Abbas-JawadWala/ESP32_BoardV1.1/1.1.22.pdf

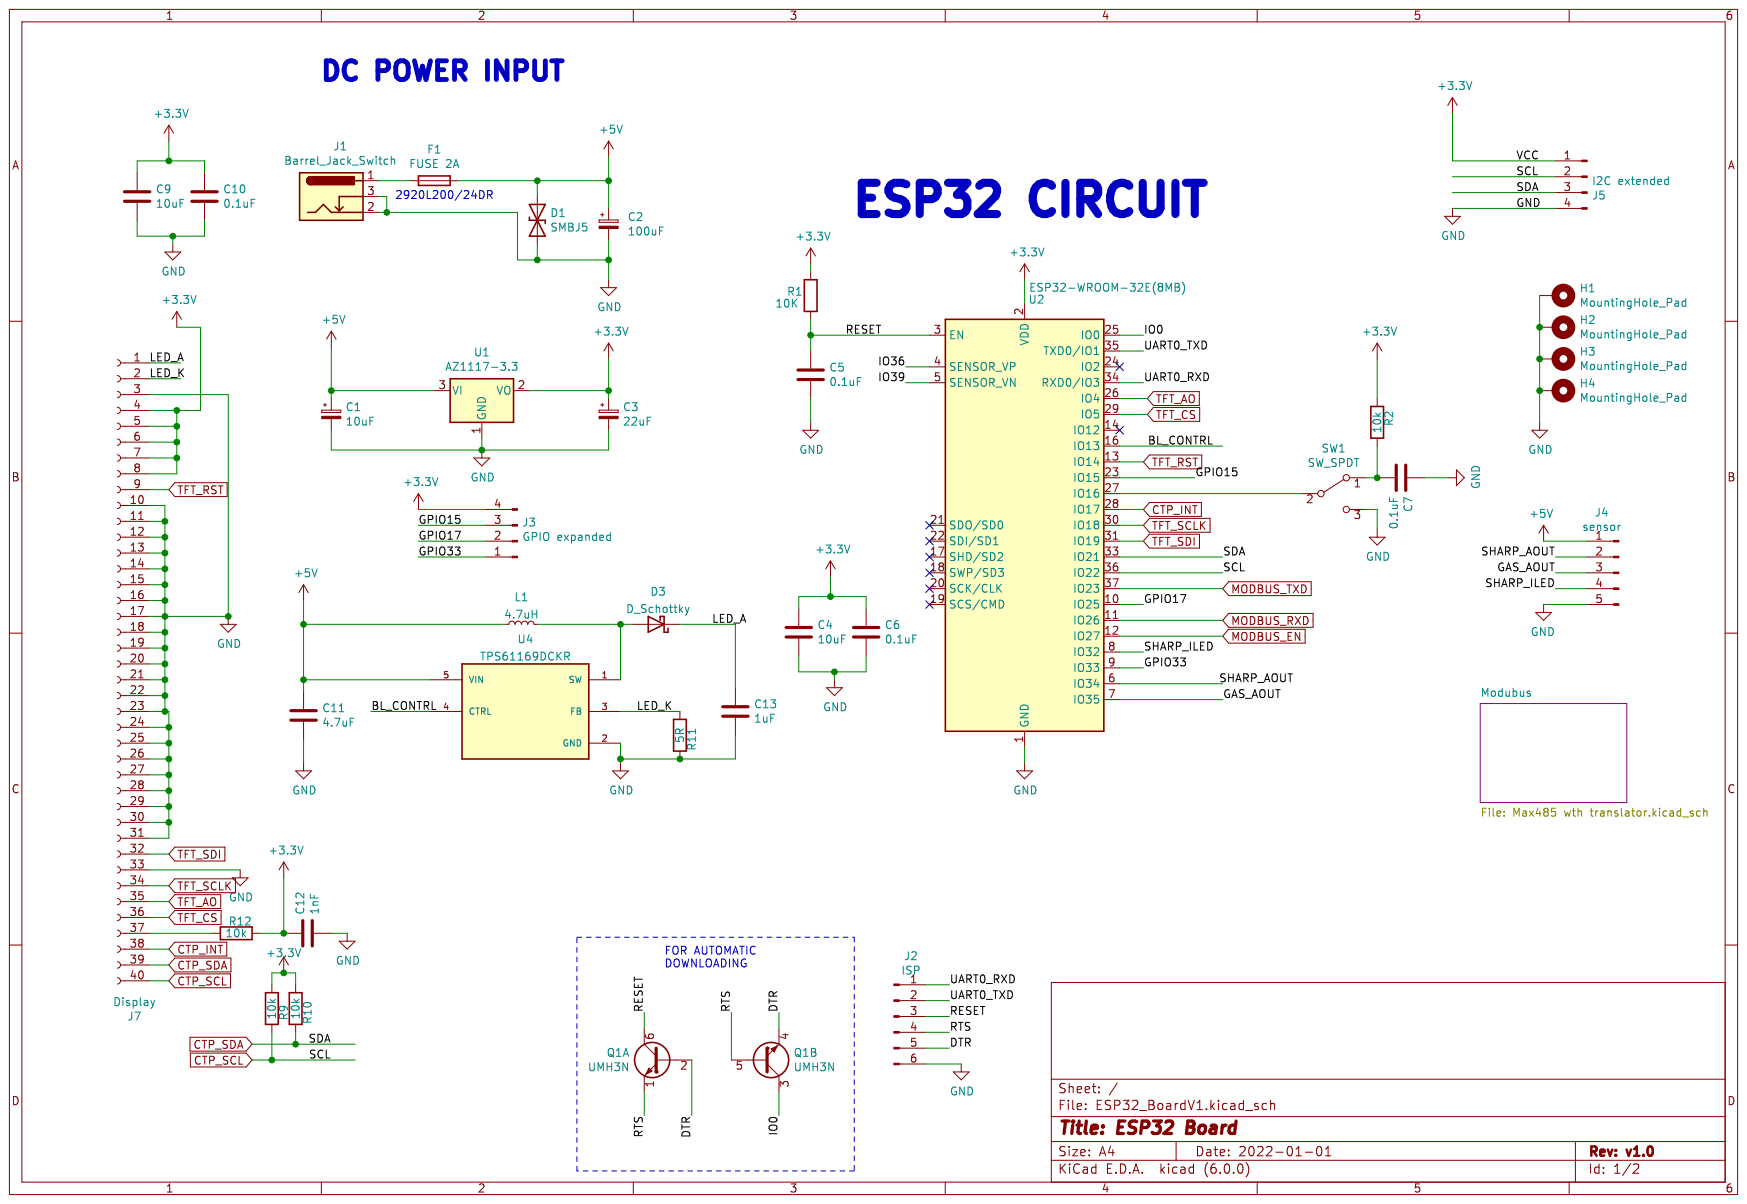
[picture p1: page 1]

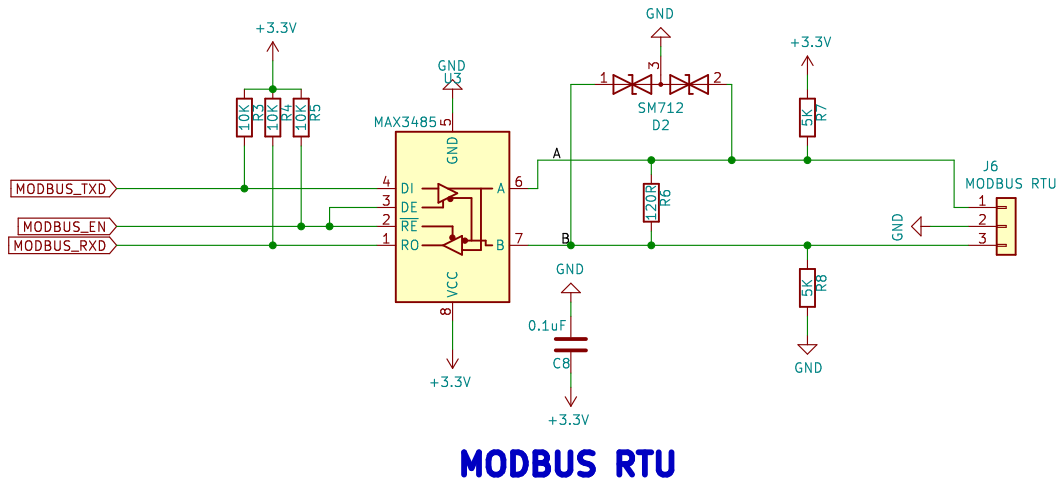
[picture p2: page 2]
