Abbas-JawadWala/ESP32_BoardV1.1/ESP32_BoardV1.kicad_pcb

## KiCad design ESP32_BoardV1.kicad_pcb (2022-02-02)

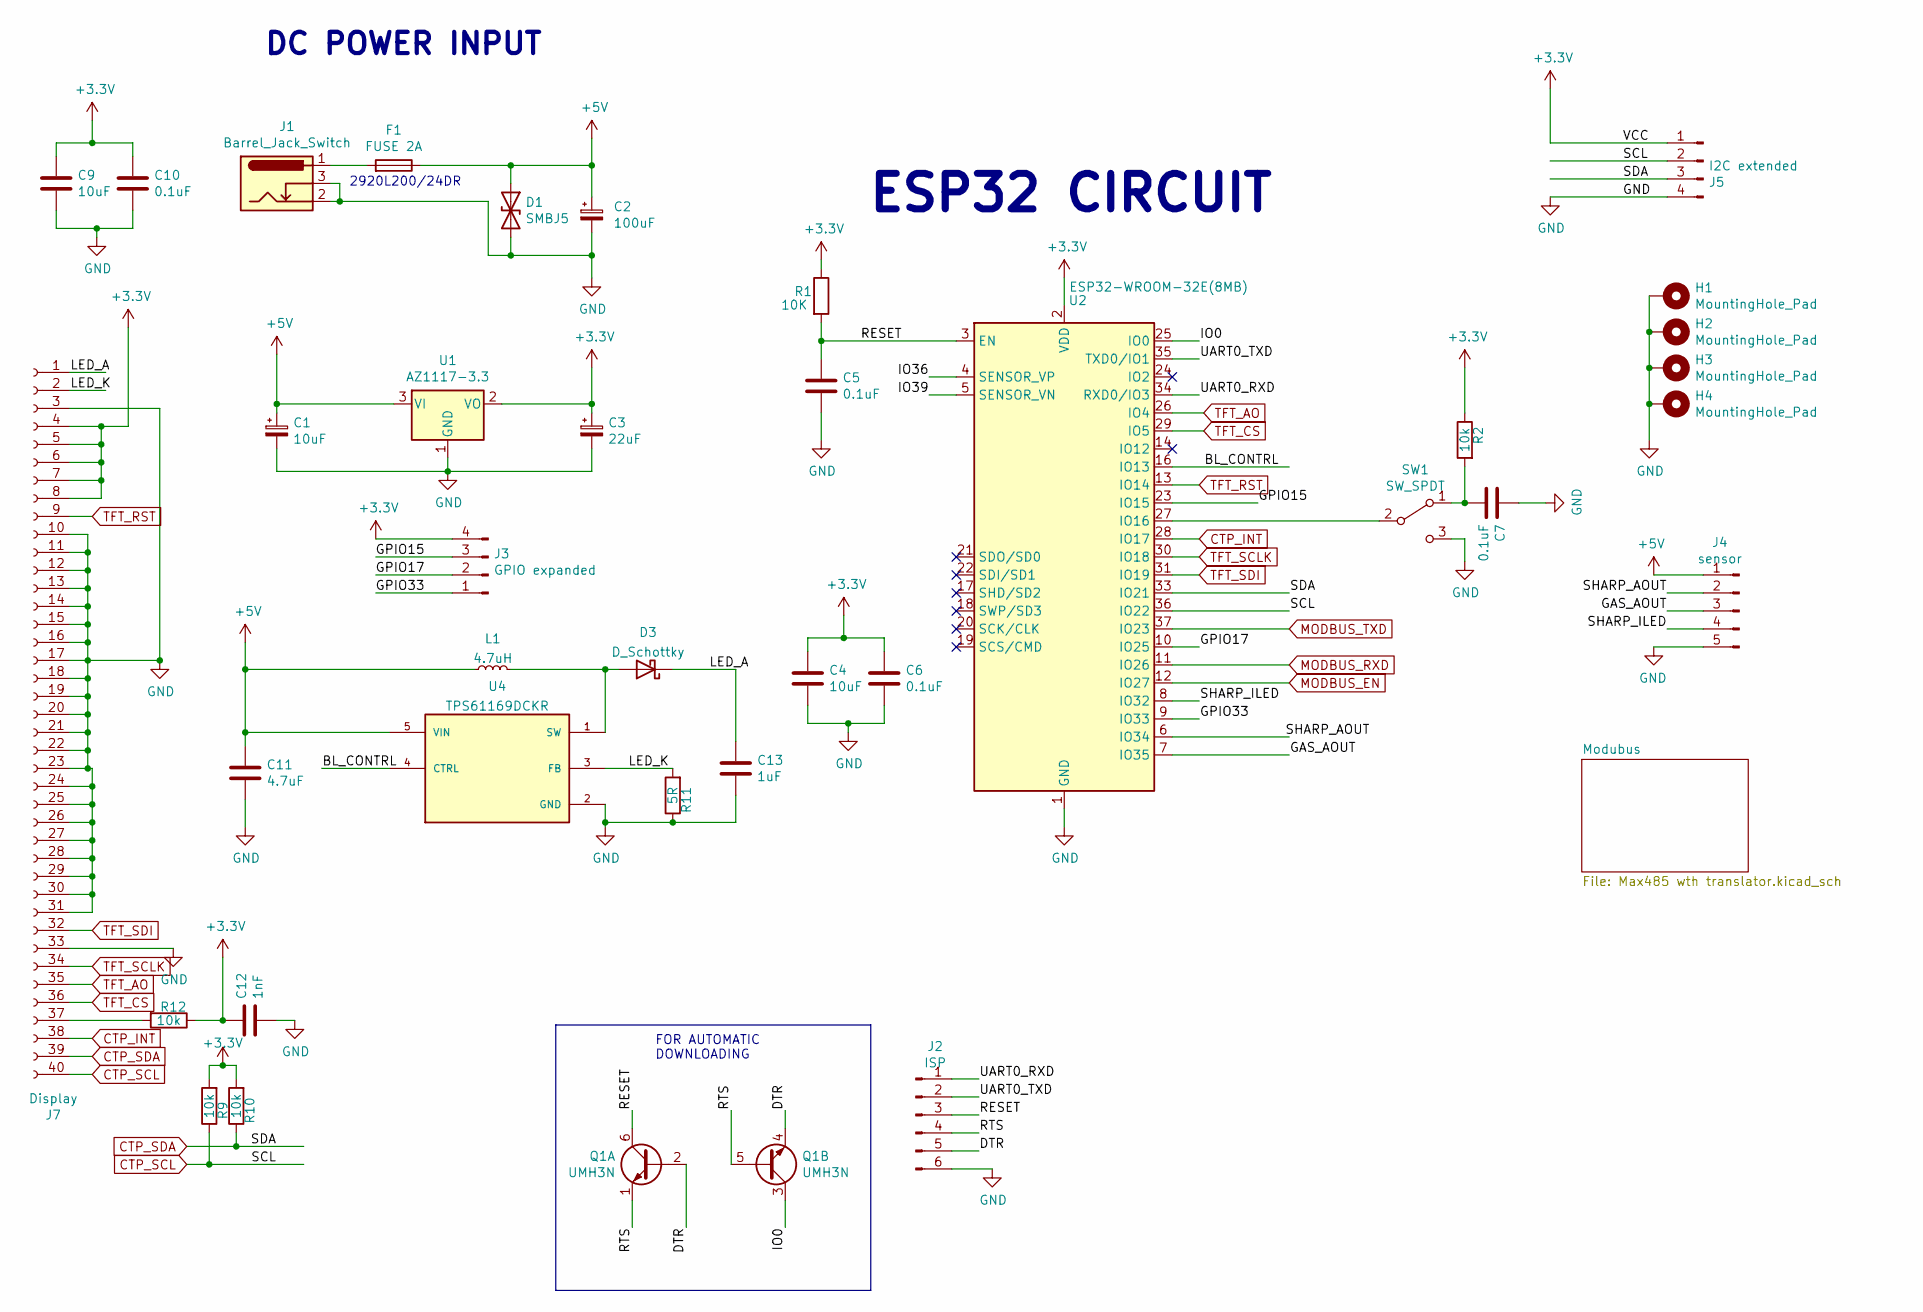
[picture p3: schematic ESP32_BoardV1.kicad_sch, ESP32 Board]

Parts:
C1: 10uF; CP_Elec_3x5.4
C2: 100uF; CP_Elec_6.3x5.4
C3: 22uF; CP_Elec_5x5.4
C4, C9: 10uF; C_0402_1005Metric_Pad0.74x0.62mm_HandSolder
C5, C6, C7, C10: 0.1uF; C_0402_1005Metric_Pad0.74x0.62mm_HandSolder
C11: 4.7uF; C_0402_1005Metric; MPN C1005X5R1A475K050BC
C12: 1nF; C_0402_1005Metric; MPN 0402ZC102KAT2A
C13: 1uF; C_0402_1005Metric; MPN C1005X6S1A105K050BC
D1: SMBJ5; D_SMB
D3: D_Schottky; D_SOD-123F; MPN RB160MM-90TR
F1: FUSE 2A; Fuse_1206_3216Metric
H1, H2, H3, H4: MountingHole_Pad; MountingHole_4.3mm_M4_Pad_Via
J1: Barrel_Jack_Switch; BarrelJack_CLIFF_FC681465S_SMT_Horizontal
J2: ISP; PinHeader_1x06_P2.54mm_Vertical
J3: GPIO expanded; JST_SM04B-SRSS-TB(LF)(SN); MPN JST_SM04B-SRSS-TB(LF)(SN)
J4: sensor; JST_SM05B-SRSS-TB(LF)(SN); MPN JST_SM05B-SRSS-TB(LF)(SN)
J5: I2C extended; JST_SM04B-SRSS-TB(LF)(SN); MPN JST_SM04B-SRSS-TB(LF)(SN)
J7: Display; Hirose_FH12-40S-0.5SH_1x40-1MP_P0.50mm_Horizontal
L1: 4.7uH; L_1008_2520Metric; MPN NRS4018T100MDGJ
Q1: UMH3N; SOT-363_SC-70-6
R1: 10K; R_0402_1005Metric_Pad0.72x0.64mm_HandSolder
R2, R9, R10, R12: 10k; R_0402_1005Metric_Pad0.72x0.64mm_HandSolder
R11: 5R; R_0402_1005Metric_Pad0.72x0.64mm_HandSolder
SW1: SW_SPDT; SW_Slide_1P2T_CK_OS102011MS2Q
U1: AZ1117-3.3; SOT-223-3_TabPin2; MPN AZ1117-3.3
U2: ESP32-WROOM-32E(8MB); ESP32-WROOM-32; MPN ESP32-WROOM-32
U4: TPS61169DCKR; SOT-353_SC-70-5; PARTREV A

Connections:
+3V3: C3.1, C4.1, C6.1, C9.1, C10.1, C12.1, J3.4, J5.1, J7.4, J7.5, J7.6, J7.7, J7.8, R1.1, R2.1, R9.2, R10.2, R12.1, U1.2 (VO), U2.2 (VDD); also elsewhere on the board
+5V: C1.1, C2.1, C11.1, D1.1 (A1), F1.1, J4.1, L1.1, U1.3 (VI), U4.5 (VIN)
/BL_CONTRL: U2.16 (IO13), U4.4 (CTRL)
/DTR: J2.5, Q1.2 (B1), Q1.4 (E2)
/GAS_AOUT: J4.3, U2.7 (IO35)
/GPIO15: J3.3, U2.23 (IO15)
/GPIO17: J3.2, U2.10 (IO25)
/GPIO33: J3.1, U2.9 (IO33)
/IO0: Q1.3 (C2), U2.25 (IO0)
/IO36: U2.4 (SENSOR_VP)
/IO39: U2.5 (SENSOR_VN)
/LED_A: C13.1, D3.1 (K), J7.1
/LED_K: J7.2, R11.2, U4.3 (FB)
/RESET: C5.1, J2.3, Q1.6 (C1), R1.2, U2.3 (EN)
/RTS: J2.4, Q1.1 (E1), Q1.5 (B2)
/SHARP_AOUT: J4.2, U2.6 (IO34)
/SHARP_ILED: J4.4, U2.8 (IO32)
/UART0_RXD: J2.1, U2.34 (RXD0/IO3)
/UART0_TXD: J2.2, U2.35 (TXD0/IO1)
CTP_INT: J7.38, U2.28 (IO17)
CTP_SCL: J5.2, J7.40, R9.1, U2.36 (IO22)
CTP_SDA: J5.3, J7.39, R10.1, U2.33 (IO21)
GND: C1.2, C2.2, C3.2, C4.2, C5.2, C6.2, C7.1, C9.2, C10.2, C11.2, C12.2, C13.2, D1.2 (A2), H1.1, H2.1, H3.1, H4.1, J1.2, J1.3, J2.6, J4.5, J5.4, J7.3, J7.10, J7.11, J7.12, J7.13, J7.14, J7.15, J7.16, J7.17, J7.18, J7.19, J7.20, J7.21, J7.22, J7.23, J7.24, J7.25, J7.26, J7.27, J7.28, J7.29, J7.30, J7.31, J7.33, R11.1, SW1.3 (C), U1.1 (GND), U2.1 (GND), U2.15 (GND), U2.38 (GND), U2.39 (GND), U4.2 (GND); also elsewhere on the board
MODBUS_EN: U2.12 (IO27); also elsewhere on the board
MODBUS_RXD: U2.11 (IO26); also elsewhere on the board
MODBUS_TXD: U2.37 (IO23); also elsewhere on the board
unnamed: C7.2, R2.2, SW1.1 (A)
unnamed: D3.2 (A), L1.2, U4.1 (SW)
unnamed: F1.2, J1.1
unnamed: J7.37, R12.2
unnamed: SW1.2 (B), U2.27 (IO16)
TFT_AO: J7.35, U2.26 (IO4)
TFT_CS: J7.36, U2.29 (IO5)
TFT_RST: J7.9, U2.13 (IO14)
TFT_SCLK: J7.34, U2.30 (IO18)
TFT_SDI: J7.32, U2.31 (IO19)

Notes on the sheet:
2920L200/24DR
FOR AUTOMATIC DOWNLOADING
DC POWER INPUT
ESP32 CIRCUIT

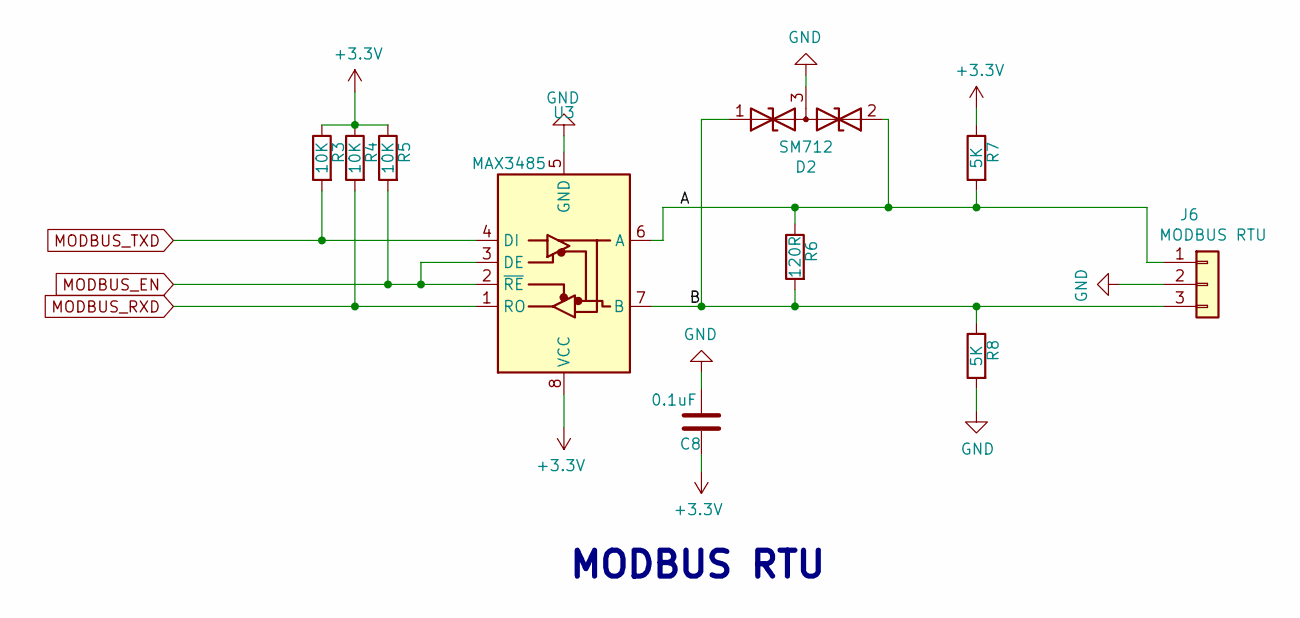
[picture p4: schematic Max485 wth translator.kicad_sch, ESP32 Board]

Parts:
C8: 0.1uF; C_0402_1005Metric_Pad0.74x0.62mm_HandSolder
D2: SM712; SOT-23
J6: MODBUS RTU; JST_SM03B-SRSS-TB(LF)(SN); MPN JST_SM03B-SRSS-TB(LF)(SN)
R3, R4, R5: 10K; R_0402_1005Metric_Pad0.72x0.64mm_HandSolder
R6: 120R; R_0402_1005Metric_Pad0.72x0.64mm_HandSolder
R7, R8: 5K; R_0402_1005Metric_Pad0.72x0.64mm_HandSolder
U3: MAX3485; SOIC-8_3.9x4.9mm_P1.27mm; MPN MAX3485

Connections:
+3V3: C8.2, R3.1, R4.1, R5.1, R7.1, U3.8 (VCC); also elsewhere on the board
/Modubus/A: D2.2 (A2), J6.1, R6.1, R7.2, U3.6 (A)
/Modubus/B: D2.1 (A1), J6.3, R6.2, R8.1, U3.7 (B)
GND: C8.1, D2.3 (common), J6.2, R8.2, U3.5 (GND); also elsewhere on the board
MODBUS_EN: R5.2, U3.2 (~RE), U3.3 (DE); also elsewhere on the board
MODBUS_RXD: R4.2, U3.1 (RO); also elsewhere on the board
MODBUS_TXD: R3.2, U3.4 (DI); also elsewhere on the board

Notes on the sheet:
MODBUS RTU

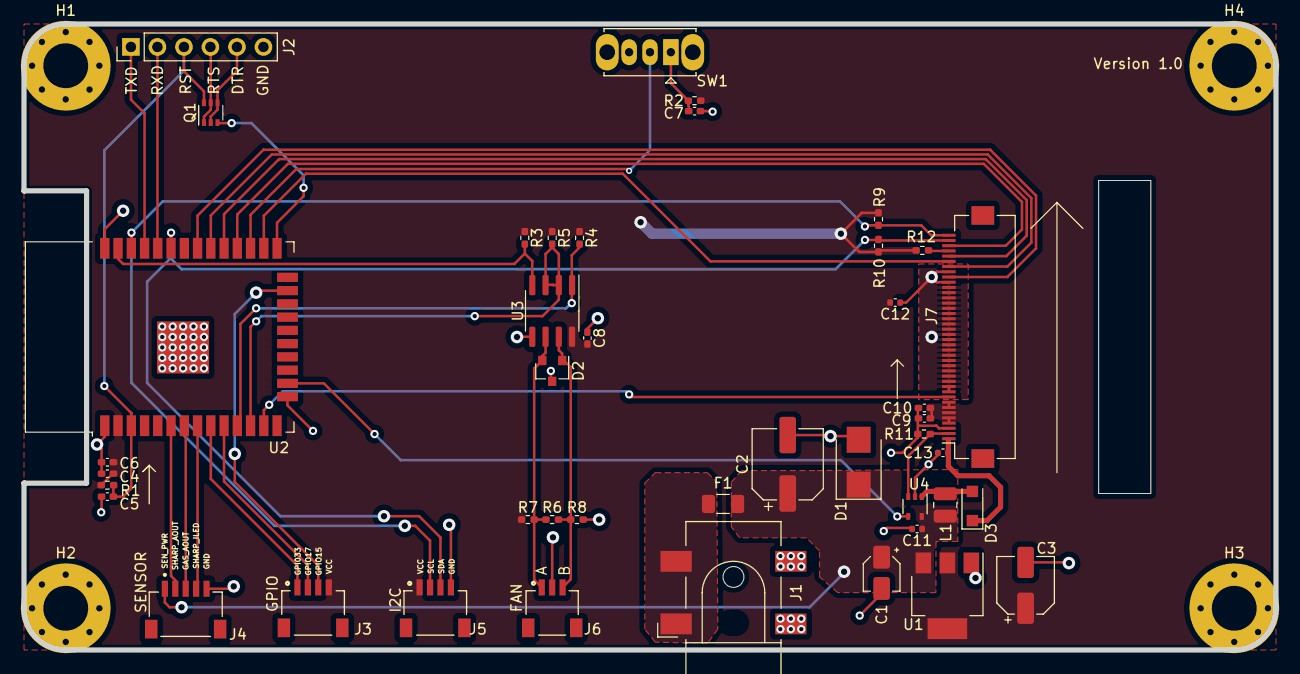
[picture p5: board ESP32_BoardV1.kicad_pcb from above]

Board: 2 copper layers, 120.0 x 60.0 mm, 47 parts (0 on the bottom side), 36 nets.
