Abbas-JawadWala/ESP32_BoardV1.1/(commit log)

2021-12-21 Recreated PCB file
    Removed old PCB files, Schematic error in existing PCB has been rectfied
    [ESP32_BoardV1.kicad_pcb, ESP32_BoardV1.sch, Max485 wth translator.sch]
2021-12-22 Pheripherial added 22.12.21
    Added display connector, I2C connector, button and MAX3485
    [Display ILI.sch, ESP32_BoardV1.sch, Max485 wth translator.sch]
2021-12-24 24.12.21
    Board layout added, Step file added
    [Display ILI.sch, ESP32_BoardV1.kicad_pcb, ESP32_BoardV1.sch, Max485 wth translator.sch]
2021-12-27 PCB completed
    [ESP32_BoardV1.csv, ESP32_BoardV1.kicad_pcb, ESP32_BoardV1.sch, Max485 wth translator.sch]
2021-12-27 Schematics change
    [ESP32_BoardV1.csv, ESP32_BoardV1.kicad_pcb, Max485 wth translator.sch]
2021-12-28 Final draft
    [24DR.step, Display ILI.kicad_sch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]
2021-12-31 Final draft with GERBER and Manufacturing Data
    [Display ILI.kicad_sch, Display ILI.sch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]
2022-01-01 Change 1/1/21
    [ESP32_BoardV1-B_Cu.gbl, ESP32_BoardV1-B_Mask.gbs, ESP32_BoardV1-B_Paste.gbp, ESP32_BoardV1-B_Silkscreen.gbo, ESP32_BoardV1-Edge_Cuts.gm1, ESP32_BoardV1-F_Cu.gtl, ESP32_BoardV1-F_Mask.gts, ESP32_BoardV1-F_Paste.gtp]
2022-01-01 added gebr and DFM data
    [ESP32_BoardV1 - ESP32_BoardV1.csv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]
2022-01-01 BOM CSV
    [ESP32_BoardV1 - ESP32_BoardV1.csv, ESP32_BoardV1.kicad_pcb, ESP32_BoardV1.kicad_sch]
